Toshi2020/Portable-FFB-wheel/(list of files, cad)

Other CAD files:
3Ddata/ハンコンDD全パーツ.f3d
