Toshi2020/Portable-FFB-wheel/MyAFFBWheelESP32DD/PwmTable.h

// 今回使用するブラシレスモーターは14極なのでNSのペアが7組ある。
// よってステータにサイン波を1周期加えるとモーターは1/7回転する。
// 一方エンコーダーは1周が4096分割(0～4095)。
// なので4095/7=585分割すればエンコーダー1LSB当たりのサインデータが得られる。
// 以下は-1～+1を0～32767に変換したデータ。
#if 0
static const int16_t PwmTable585[585] = {
	16384,16559,16735,16911,17087,17263,17439,17614,17790,17965,
	18140,18315,18489,18664,18838,19012,19185,19358,19531,19704,
	19876,20048,20219,20390,20560,20730,20899,21068,21237,21404,
	21572,21738,21904,22070,22234,22398,22562,22724,22886,23047,
	23208,23367,23526,23684,23841,23997,24153,24307,24461,24613,
	24765,24916,25065,25214,25362,25509,25654,25799,25942,26085,
	26226,26366,26505,26643,26779,26915,27049,27182,27313,27444,
	27573,27701,27828,27953,28077,28199,28321,28440,28559,28676,
	28791,28906,29018,29130,29240,29348,29455,29560,29664,29766,
	29867,29966,30064,30160,30254,30347,30438,30528,30616,30702,
	30787,30870,30951,31031,31109,31185,31260,31333,31404,31473,
	31541,31607,31671,31733,31794,31853,31910,31965,32019,32070,
	32120,32168,32214,32259,32301,32342,32381,32418,32453,32487,
	32518,32548,32575,32601,32625,32648,32668,32686,32703,32717,
	32730,32741,32750,32757,32762,32766,32767,32766,32764,32760,
	32754,32746,32736,32724,32710,32695,32677,32658,32637,32614,
	32589,32562,32533,32503,32470,32436,32400,32362,32322,32280,
	32237,32192,32144,32095,32045,31992,31938,31882,31824,31764,
	31702,31639,31574,31507,31439,31368,31296,31223,31147,31070,
	30991,30911,30829,30745,30659,30572,30483,30393,30301,30207,
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
	3997,3818,3643,3472,3306,3144,2987,2834,2686,2542,
	2402,2267,2136,2010,1888,1770,1657,1548,1443,1342,
	1246,1154,1066,981,901,825,753,684,620,559,
	501,447,397,350,307,267,230,196,165,137,
	113,90,71,54,40,28,19,12,7,4,
	3,4,6,11,17,24,33,44,55,68,
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
#endif
